paulsykes/ft231x_uart_usb_power_switch/docsrc/basegpiolinux.rst

First we determine the base GPIO address of the device. To do this, look for new entries in /sys/class/gpio after you connect the device.

.. code-block:: console

    $ ls /sys/class/gpio/
    $ export  gpiochip508@  unexport
