paulsykes/ft231x_uart_usb_power_switch/docsrc/index.rst

.. FT231X Breakout with USB Power Switch documentation master file, created by
   sphinx-quickstart on Sun Feb 14 19:01:14 2021.
   You can adapt this file completely to your liking, but it should at least
   contain the root `toctree` directive.

Welcome to FT231X UART with USB Power Switch's documentation!
=================================================================

FT231X USB to serial UART with integrated current limited USB power switch.

.. toctree::
   :maxdepth: 1

   usbpower
   overcurrent
   currentlimit
   eeprom
