paulsykes/ft231x_uart_usb_power_switch/docsrc/currentlimit.rst

=============
Current Limit
=============

Current limit is controlled by resistor 'R7' which is connected to the 'ILIM' pin of power distribution switch (TPS2553). The devices ships with a value of 52.3kOhms which equates to a current limit of 500mA.
