paulsykes/ft231x_uart_usb_power_switch/docsrc/overlinuxsudo.rst

.. include:: basegpiolinux.rst

In this case, the base address is **508**.
 * CBUS3, which is FT231X GPIO3, will map to **511**.

Export CBUS3 (GPIO3).

.. code-block:: console

    $ echo 511 | sudo tee /sys/class/gpio/export

Set direction to input.

.. code-block:: console

    $ echo in | sudo tee /sys/class/gpio/gpio511/direction

Read input status (1 = Okay, 0 = Over Current).

.. code-block:: console

    $ cat /sys/class/gpio/gpio511/value
    1
