paulsykes/ft231x_uart_usb_power_switch/docsrc/usbpower.rst

==========================
Switching USB Power Output
==========================

.. toctree::
    :maxdepth: 1

.. tabs::

    .. group-tab:: Linux (sudo)

        .. include:: usblinuxsudo.rst

    .. group-tab:: Linux

        .. include:: usblinux.rst

    .. group-tab:: Mac OSX

        .. include:: usbmac.rst

    .. group-tab:: Windows

        .. include:: usbwindows.rst
