paulsykes/ft231x_uart_usb_power_switch/docsrc/overcurrent.rst

================================
Reading Over Current Status Flag
================================

.. toctree::
    :maxdepth: 1

.. tabs::

    .. group-tab:: Linux (sudo)

        .. include:: overlinuxsudo.rst

    .. group-tab:: Linux

        .. include:: overlinux.rst

    .. group-tab:: Mac OSX

        .. include:: overmac.rst

    .. group-tab:: Windows

        .. include:: overwindows.rst
