paulsykes/ft231x_uart_usb_power_switch/hardware/kicad/images/inti.png

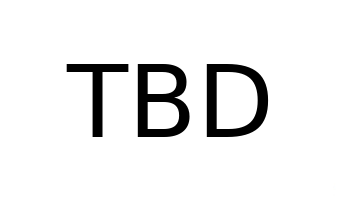
hardware/kicad/images/inti.png
