paulsykes/ft231x_uart_usb_power_switch/(list of files, cad)

Other CAD files:
hardware/freecad/board_outline_f.FCStd
hardware/freecad/board_outline.FCStd
hardware/freecad/board_outline.dxf
hardware/freecad/board_outline_f.dxf
