paulsykes/ft231x_uart_usb_power_switch/hardware/kicad/ft231x_uart_usb_power_switch/ft231x_uart_usb_power_switch.kicad_pcb

## KiCad design hardware/kicad/ft231x_uart_usb_power_switch/ft231x_uart_usb_power_switch.kicad_pcb (2022-02-27)

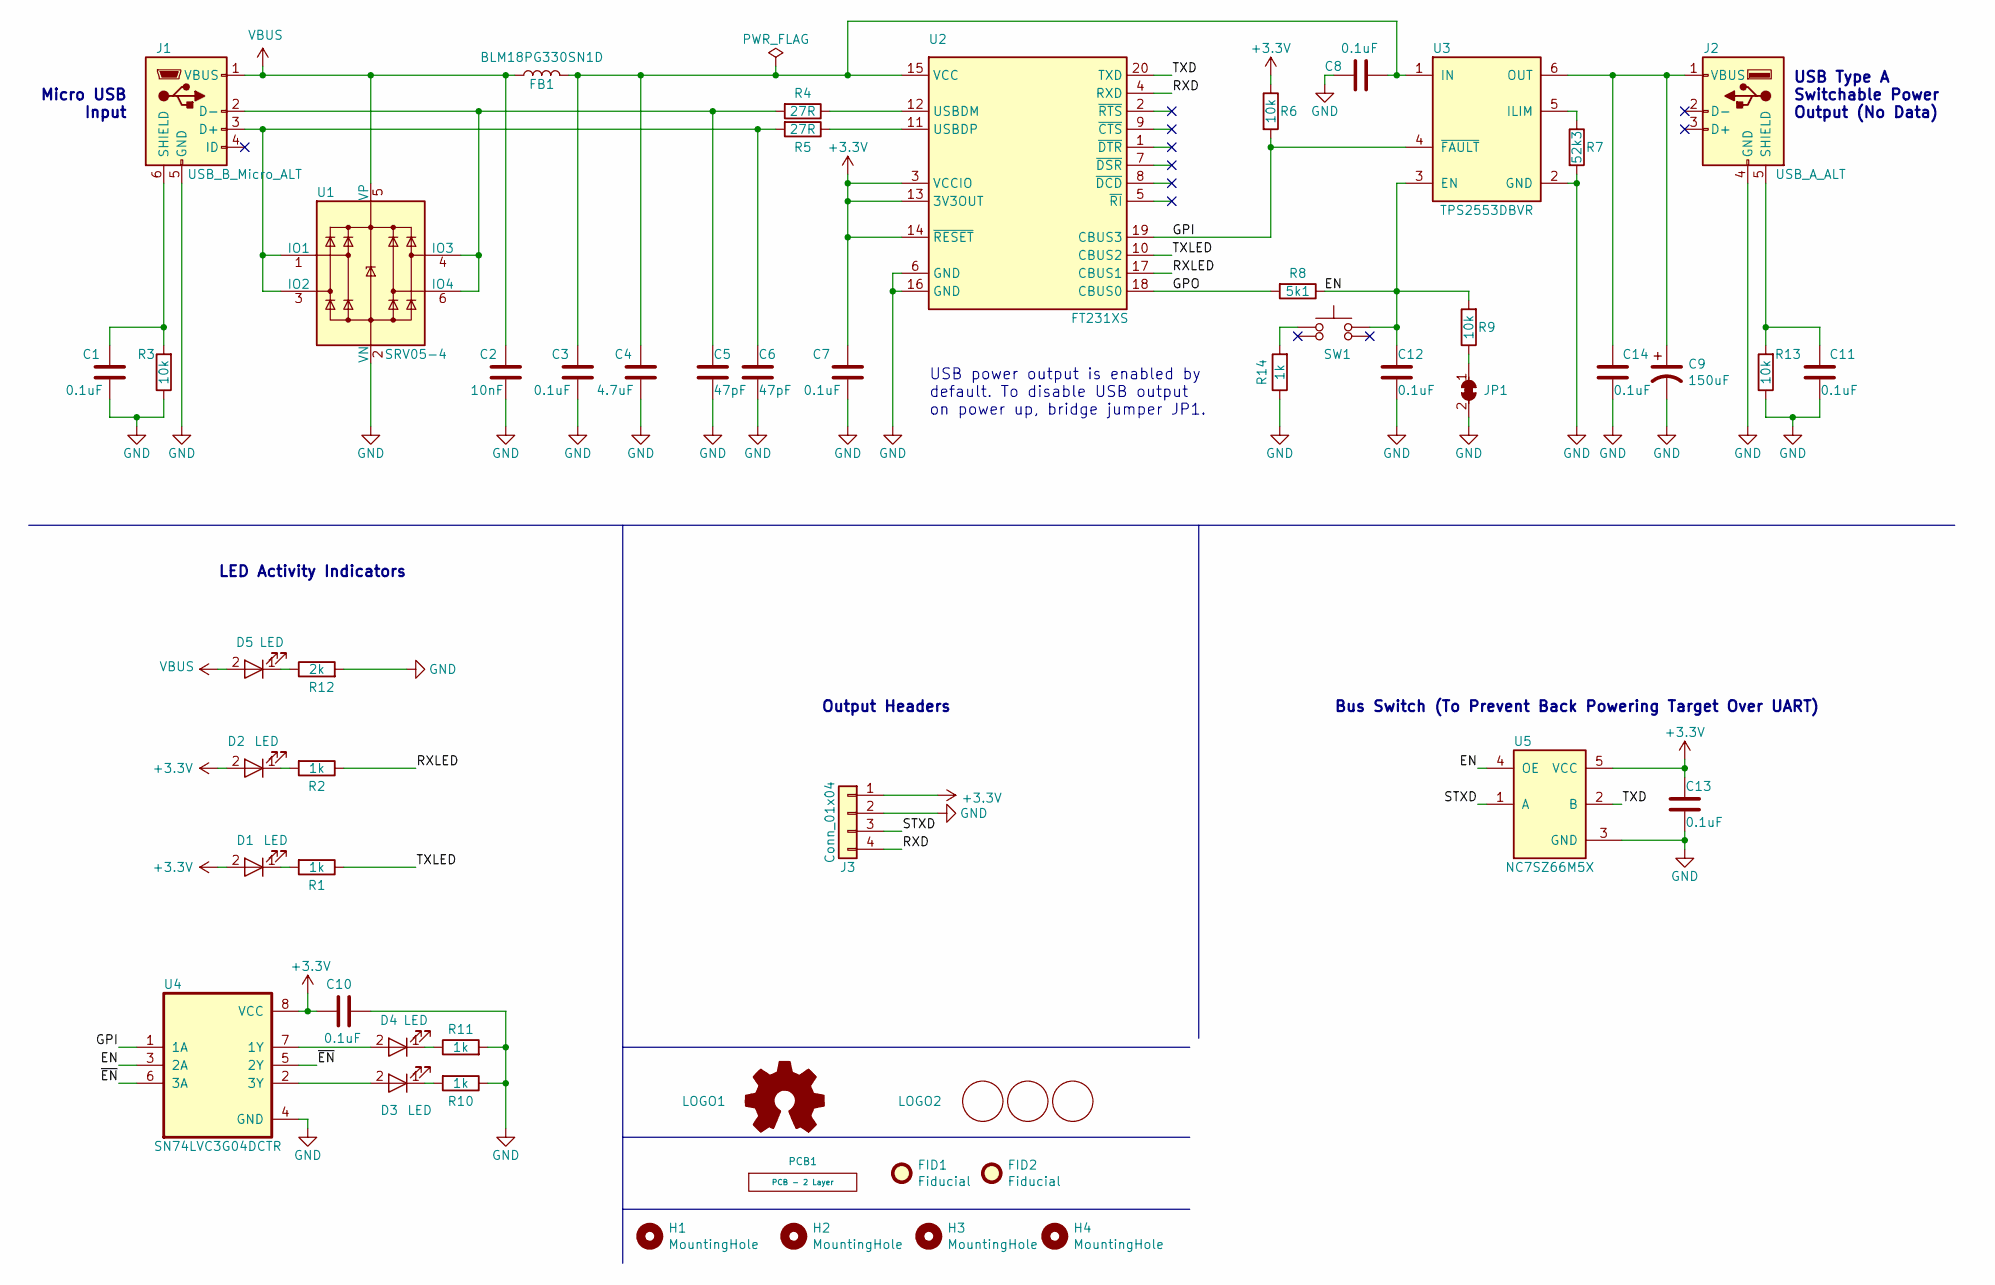
[picture p2: schematic ft231x_uart_usb_power_switch.kicad_sch, ft231x uart usb power switch]

Parts:
C1, C3, C7, C8, C10, C11, C12, C13, C14: 0.1uF; C_0603; mouser# 603-CC603KRX7R9BB104; LCSC# C14663
C2: 10nF; C_0603; mouser# 603-CC603KRX7R9BB103; LCSC# C100042
C4: 4.7uF; C_0603; mouser# 603-CC603KRX5R6BB475; LCSC# C109456
C5, C6: 47pF; C_0603; mouser# 603-CC603JRNPO9BN470; LCSC# C105622
C9: 150uF; EIA-3528-12_Kemet-T_DENSITY_MEDIUM; mouser# 80-T520B157M006ATE25; LCSC# C156458
D1, D2, D3, D4, D5: LED; LED_0603_1608Metric; mouser# 638-19217GHCYR1S23T; LCSC# C72043
FB1: BLM18PG330SN1D; FB_0603; mouser# 81-BLM18PG330SN1D; LCSC# C88984
FID1, FID2: Fiducial; Fiducial_1mm_Mask2mm
H1, H3: MountingHole; MountingHole_2.6mm_annular
H2, H4: MountingHole; MountingHole_2.6mm_nocrtyd
J1: USB_B_Micro_ALT; AMPHENOL_10118194-0001LF; mouser# 649-10118194-0001LF; LCSC# C132563
J2: USB_A_ALT; TE_292303-1; mouser# 571-292303-1; LCSC# C86461
J3: Conn_01x04; PinHeader_1x04_P2.54mm_Vertical_Arduino; LCSC# C124378
JP1: SolderJumper_2_Bridged_Alt; SolderJumper-2_P1.3mm_Un-Bridged_RoundedPad1.0x1.5mm
LOGO1: Logo_Open_Hardware_Small; OSHW-Logo2_7.3x6mm_SilkScreen
LOGO2: Logo_CC_BY_SA; cc_by_sa
PCB1: PCB - 2 Layer
R1, R2, R10, R11, R14: 1k; R_0603; mouser# 603-RC0603JR-071KL; LCSC# C14676
R3, R6, R9, R13: 10k; R_0603; mouser# 603-RC0603JR-0710KL; LCSC# C99198
R4, R5: 27R; R_0603; mouser# 603-RC0603FR-0727RL; LCSC# C137753
R7: 52k3; R_0603; mouser# 603-RC0603FR-0752K3L; LCSC# C185323
R8: 5k1; R_0603; mouser# 603-RC0603JR-075K1L; LCSC# C14677
R12: 2k; R_0603; mouser# 603-RC0603JR-072KL; LCSC# C105581
SW1: PTS810SJK250SMTRLFS; PTS810SJK250SMTRLFS-TACT4.2MM; mouser# 611-PTS810SJK250SMTR; LCSC# C221896
U1: SRV05-4; SOT-23-6; LCSC# C558418
U2: FT231XS; SSOP-20_3.9x8.7mm_P0.635mm; mouser# 895-FT231XS-R; LCSC# C132160
U3: TPS2553DBVR; VSON-10-1EP_3x3mm_P0.5mm_EP1.65x2.4mm_ThermalVias; mouser# 595-TPS2553DBVR; LCSC# C55266
U4: SN74LVC3G04DCTR; SSOP-8_2.95x2.8mm_P0.65mm; mouser# 595-SN74LVC3G04DCTR; LCSC# C139324
U5: NC7SZ66M5X; SOT-23-5; mouser# 512-NC7SZ66M5X; LCSC# C232791

Connections:
+3V3: C7.1, C10.1, C13.1, D1.2 (A), D2.2 (A), J3.1, R6.1, U2.3 (VCCIO), U2.13 (3V3OUT), U2.14 (~RESET), U4.8 (VCC), U5.5 (VCC)
/EN: C12.1, R8.1, R9.2, SW1.3 (B), U3.3 (EN), U4.3 (2A), U5.4 (OE)
/GPI: R6.2, U2.19 (CBUS3), U3.4 (~FAULT), U4.1 (1A)
/GPO: R8.2, U2.18 (CBUS0)
/RXD: J3.4, U2.4 (RXD)
/RXLED: R2.1, U2.17 (CBUS1)
/STXD: J3.3, U5.1 (A)
/TXD: U2.20 (TXD), U5.2 (B)
/TXLED: R1.1, U2.10 (CBUS2)
/~EN: U4.5 (2Y), U4.6 (3A)
GND: C1.2, C2.2, C3.2, C4.2, C5.2, C6.2, C7.2, C8.1, C9.2, C10.2, C11.2, C12.2, C13.2, C14.2, J1.5 (GND), J2.4 (GND), J3.2, JP1.2 (B), R3.1, R7.2, R10.1, R11.2, R12.2, R13.1, R14.1, U1.2 (VN), U2.6 (GND), U2.16 (GND), U3.2 (GND), U4.4 (GND), U5.3 (GND)
unnamed: C1.1, J1.6 (SHIELD), R3.2
unnamed: C3.1, C4.1, C8.2, FB1.2, U2.15 (VCC), U3.1 (IN)
unnamed: C5.1, J1.2 (D-), R4.2, U1.4 (IO3), U1.6 (IO4)
unnamed: C6.1, J1.3 (D+), R5.2, U1.1 (IO1), U1.3 (IO2)
unnamed: C11.1, J2.5 (SHIELD), R13.2
unnamed: C9.1, C14.1, J2.1 (VBUS), U3.6 (OUT)
unnamed: D1.1 (K), R1.2
unnamed: D2.1 (K), R2.2
unnamed: D3.1 (K), R10.2
unnamed: D3.2 (A), U4.2 (3Y)
unnamed: D4.1 (K), R11.1
unnamed: D4.2 (A), U4.7 (1Y)
unnamed: D5.1 (K), R12.1
unnamed: JP1.1 (A), R9.1
unnamed: R4.1, U2.12 (USBDM)
unnamed: R5.1, U2.11 (USBDP)
unnamed: R7.1, U3.5 (ILIM)
unnamed: R14.2, SW1.1 (A)
VBUS: C2.1, D5.2 (A), FB1.1, J1.1 (VBUS), U1.5 (VP)

Notes on the sheet:
USB power output is enabled by default. To disable USB output on power up, bridge jumper JP1.
Output Headers
Micro USB Input
Bus Switch (To Prevent Back Powering Target Over UART)
USB Type A Switchable Power Output (No Data)
LED Activity Indicators

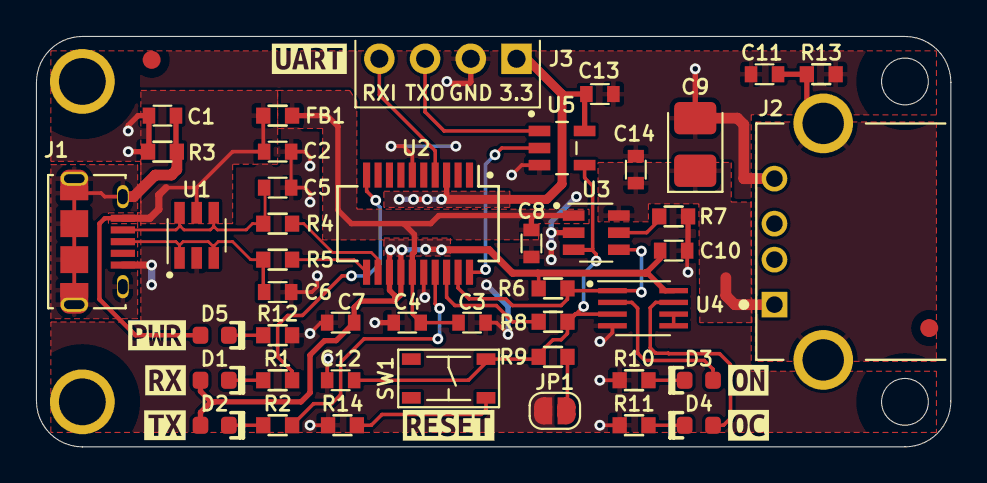
[picture p3: board ft231x_uart_usb_power_switch.kicad_pcb from above]

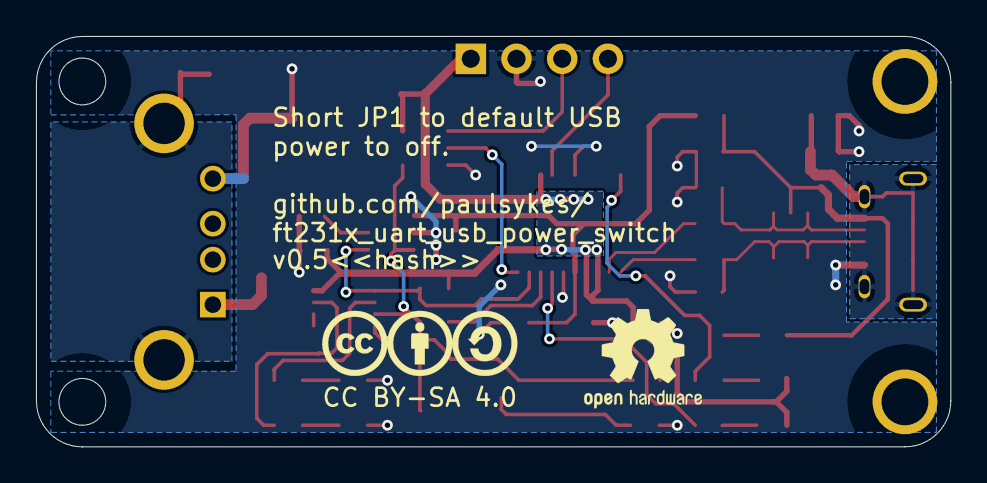
[picture p4: board ft231x_uart_usb_power_switch.kicad_pcb from below]

Board: 2 copper layers, 50.8 x 22.8 mm, 59 parts (2 on the bottom side), 30 nets.

Other parts of the board:
kibuzzard-6210B9B1: G***; kibuzzard-6210B9B1
kibuzzard-6210BA4A: G***; kibuzzard-6210BA4A
kibuzzard-6210BA5D: G***; kibuzzard-6210BA5D
kibuzzard-6210BA32: G***; kibuzzard-6210BA32
kibuzzard-6210BA40: G***; kibuzzard-6210BA40
kibuzzard-6210BA51: G***; kibuzzard-6210BA51
kibuzzard-6210BA58: G***; kibuzzard-6210BA58
