paulsykes/ft231x_uart_usb_power_switch/(commit log)

2021-02-08 initial import
    [board_outline.FCStd, board_outline.dxf, ft231x_breakout_usb_power_switch.kicad_pcb, ft231x_breakout_usb_power_switch.sch]
2021-02-08 more local 3d models
    [ft231x_breakout_usb_power_switch.kicad_pcb]
2021-02-09 add usb to led silkscreen
    [ft231x_breakout_usb_power_switch.kicad_pcb]
2021-02-09 CI test
    [ft231x_breakout_usb_power_switch.sch]
2021-02-09 tidy up kibot library warnings
    [ft231x_breakout_usb_power_switch.sch]
2021-02-09 initial gerber test
2021-02-16 add JLCPCB gerber generation
2021-02-17 PCB vendor configs
2021-02-17 add layout version number
    [ft231x_breakout_usb_power_switch.kicad_pcb]
2021-02-17 jlc style bom and position file generation
    [ft231x_breakout_usb_power_switch.sch]
2021-02-18 Bom fields test
    [ft231x_breakout_usb_power_switch.kicad_pcb, ft231x_breakout_usb_power_switch.sch]
2021-02-18 change footprint FT231XS to fix lcsc rotation filter
    [ft231x_breakout_usb_power_switch.kicad_pcb, ft231x_breakout_usb_power_switch.sch]
2021-02-18 remove unused footprint
2021-02-18 Add substitute field
    [ft231x_breakout_usb_power_switch.sch]
2021-02-18 Add value to kibot kibom grouping
    [ft231x_breakout_usb_power_switch.sch]
2021-02-18 bom fields for 0.1uF caps
    [ft231x_breakout_usb_power_switch.sch]
2021-02-18 10nF cap BOM fields
    [ft231x_breakout_usb_power_switch.sch]
2021-02-18 BOM fields 47 pF cap
    [ft231x_breakout_usb_power_switch.sch]
2021-02-18 4.7 uF BOM fields
    [ft231x_breakout_usb_power_switch.sch]
2021-02-18 150 uF cap bom fields
    [ft231x_breakout_usb_power_switch.sch]
2021-02-18 LED bom fields
    [ft231x_breakout_usb_power_switch.sch]
2021-02-19 bom fields for more parts
    [ft231x_breakout_usb_power_switch.sch]
2021-02-19 update more fields bom
    [ft231x_breakout_usb_power_switch.sch]
2021-02-19 Update Bom fields connectors
    [ft231x_breakout_usb_power_switch.sch]
2021-02-21 Tidy up footprints and BoM fields
    [ft231x_breakout_usb_power_switch.kicad_pcb, ft231x_breakout_usb_power_switch.sch]
2021-02-26 exclude mounting holes
2021-02-26 remove solder jumper from bom
2021-02-26 early partsbox bom support
2021-02-27 remove F from filter as this was filtering out ferrite beads
2021-02-27 Add details BoM details for ferrite bead
    [ft231x_breakout_usb_power_switch.sch]
2021-02-27 pad version number
    [ft231x_breakout_usb_power_switch.kicad_pcb, ft231x_breakout_usb_power_switch.sch]
2021-03-01 reset switch initial
    [ft231x_breakout_usb_power_switch.kicad_pcb, ft231x_breakout_usb_power_switch.sch]
2021-03-01 fix unconnected ground
    [ft231x_breakout_usb_power_switch.kicad_pcb]
2021-03-01 add optional pull down to enable
    [ft231x_breakout_usb_power_switch.kicad_pcb, ft231x_breakout_usb_power_switch.sch]
2021-03-02 Reset switch and bus switches routed
    [ft231x_breakout_usb_power_switch.kicad_pcb, ft231x_breakout_usb_power_switch.sch]
2021-03-03 increase pad sizes for easier hand assembly
    [ft231x_breakout_usb_power_switch.kicad_pcb]
2021-03-03 remove tag filter
2021-03-03 Fix reset when FT231X is drivng power switch OE
    [ft231x_breakout_usb_power_switch.kicad_pcb, ft231x_breakout_usb_power_switch.sch]
2021-03-03 KiBuzzard labels
    [ft231x_breakout_usb_power_switch.kicad_pcb]
2021-03-09 use github workflow to add hash to silkscreen
    [ft231x_breakout_usb_power_switch.kicad_pcb]
2021-03-16 Add two fiducials
    [ft231x_breakout_usb_power_switch.kicad_pcb, ft231x_breakout_usb_power_switch.sch]
2021-03-23 update resistor values in enable line
    [ft231x_breakout_usb_power_switch.kicad_pcb, ft231x_breakout_usb_power_switch.sch]
2021-03-23 remove breakout headers and simplify
    [ft231x_breakout_usb_power_switch.kicad_pcb, ft231x_breakout_usb_power_switch.sch]
2021-03-24 change to larger tactile switch
    [ft231x_breakout_usb_power_switch.kicad_pcb, ft231x_breakout_usb_power_switch.sch]
2021-03-24 use buffer for on indicator
    [ft231x_breakout_usb_power_switch.kicad_pcb, ft231x_breakout_usb_power_switch.sch]
2021-03-25 0.3-rc1 removed breakout headers
    [board_outline_f.FCStd, board_outline_f.dxf, ft231x_breakout_usb_power_switch.kicad_pcb, ft231x_breakout_usb_power_switch.sch]
2021-03-25 0.3 rc2 fix zone fills
    [ft231x_breakout_usb_power_switch.kicad_pcb]
2021-03-25 Add open hardware logos
    [ft231x_breakout_usb_power_switch.kicad_pcb, ft231x_breakout_usb_power_switch.sch]
2021-03-25 add missing 3d model
    [ft231x_breakout_usb_power_switch.kicad_pcb]
2021-03-25 update 3d model in library
    [ft231x_breakout_usb_power_switch.kicad_pcb]
2021-03-25 add dot
    [ft231x_breakout_usb_power_switch.kicad_pcb]
2021-03-25 re-add silk buzzard labels
    [ft231x_breakout_usb_power_switch.kicad_pcb, ft231x_breakout_usb_power_switch.sch]
2021-03-26 rename project breakout to uart
    [ft231x_uart_usb_power_switch.kicad_pcb, ft231x_uart_usb_power_switch.sch]
2021-03-26 rename kibot file breakout to uart
2021-03-26 update documentation breakout to uart
2021-03-26 remove fiducials from bom
2021-03-26 add back sym-lib-table
    [ft231x_uart_usb_power_switch.sch]
2021-10-14 Update Design Based On Feedback
    * Add Power LED
    * Add 3.3V to header
    * Swap RX and TX Label (This was labelled from USB perspective, now labelled from UART perspective)
    [ft231x_uart_usb_power_switch.kicad_pcb, ft231x_uart_usb_power_switch.sch]
2022-02-07 Update source files to kicad 6
    [ft231x_uart_usb_power_switch.kicad_pcb, ft231x_uart_usb_power_switch.kicad_sch]
2022-02-07 Move pcb fab to dev_k6
2022-02-07 Update revision to 0.4
    [ft231x_uart_usb_power_switch.kicad_pcb, ft231x_uart_usb_power_switch.kicad_sch]
2022-02-19 Increase size of kibuzzard labels
    [ft231x_uart_usb_power_switch.kicad_pcb, ft231x_uart_usb_power_switch.kicad_sch]
2022-02-27 Open up solder paste holes for mechanical pins Micro USB
    [ft231x_uart_usb_power_switch.kicad_pcb]
