paulsykes/ft231x_uart_usb_power_switch/(notices)

Notices in the files:
parts and their libraries:
CC BY-SA 4.0
